mathias-aland/battery-monitor-v1/README.md

# battery-monitor-v1
PCBs created with EAGLE 7.7.0  
Gateway FW created with ESP-IDF Eclipse  
Node FW created with Simplicity Studio  
**More info will be added later!**
