mathias-aland/battery-monitor-v1/hw/batt_mon_v1_gateway/wifi_lora_gw_v1_1.pdf

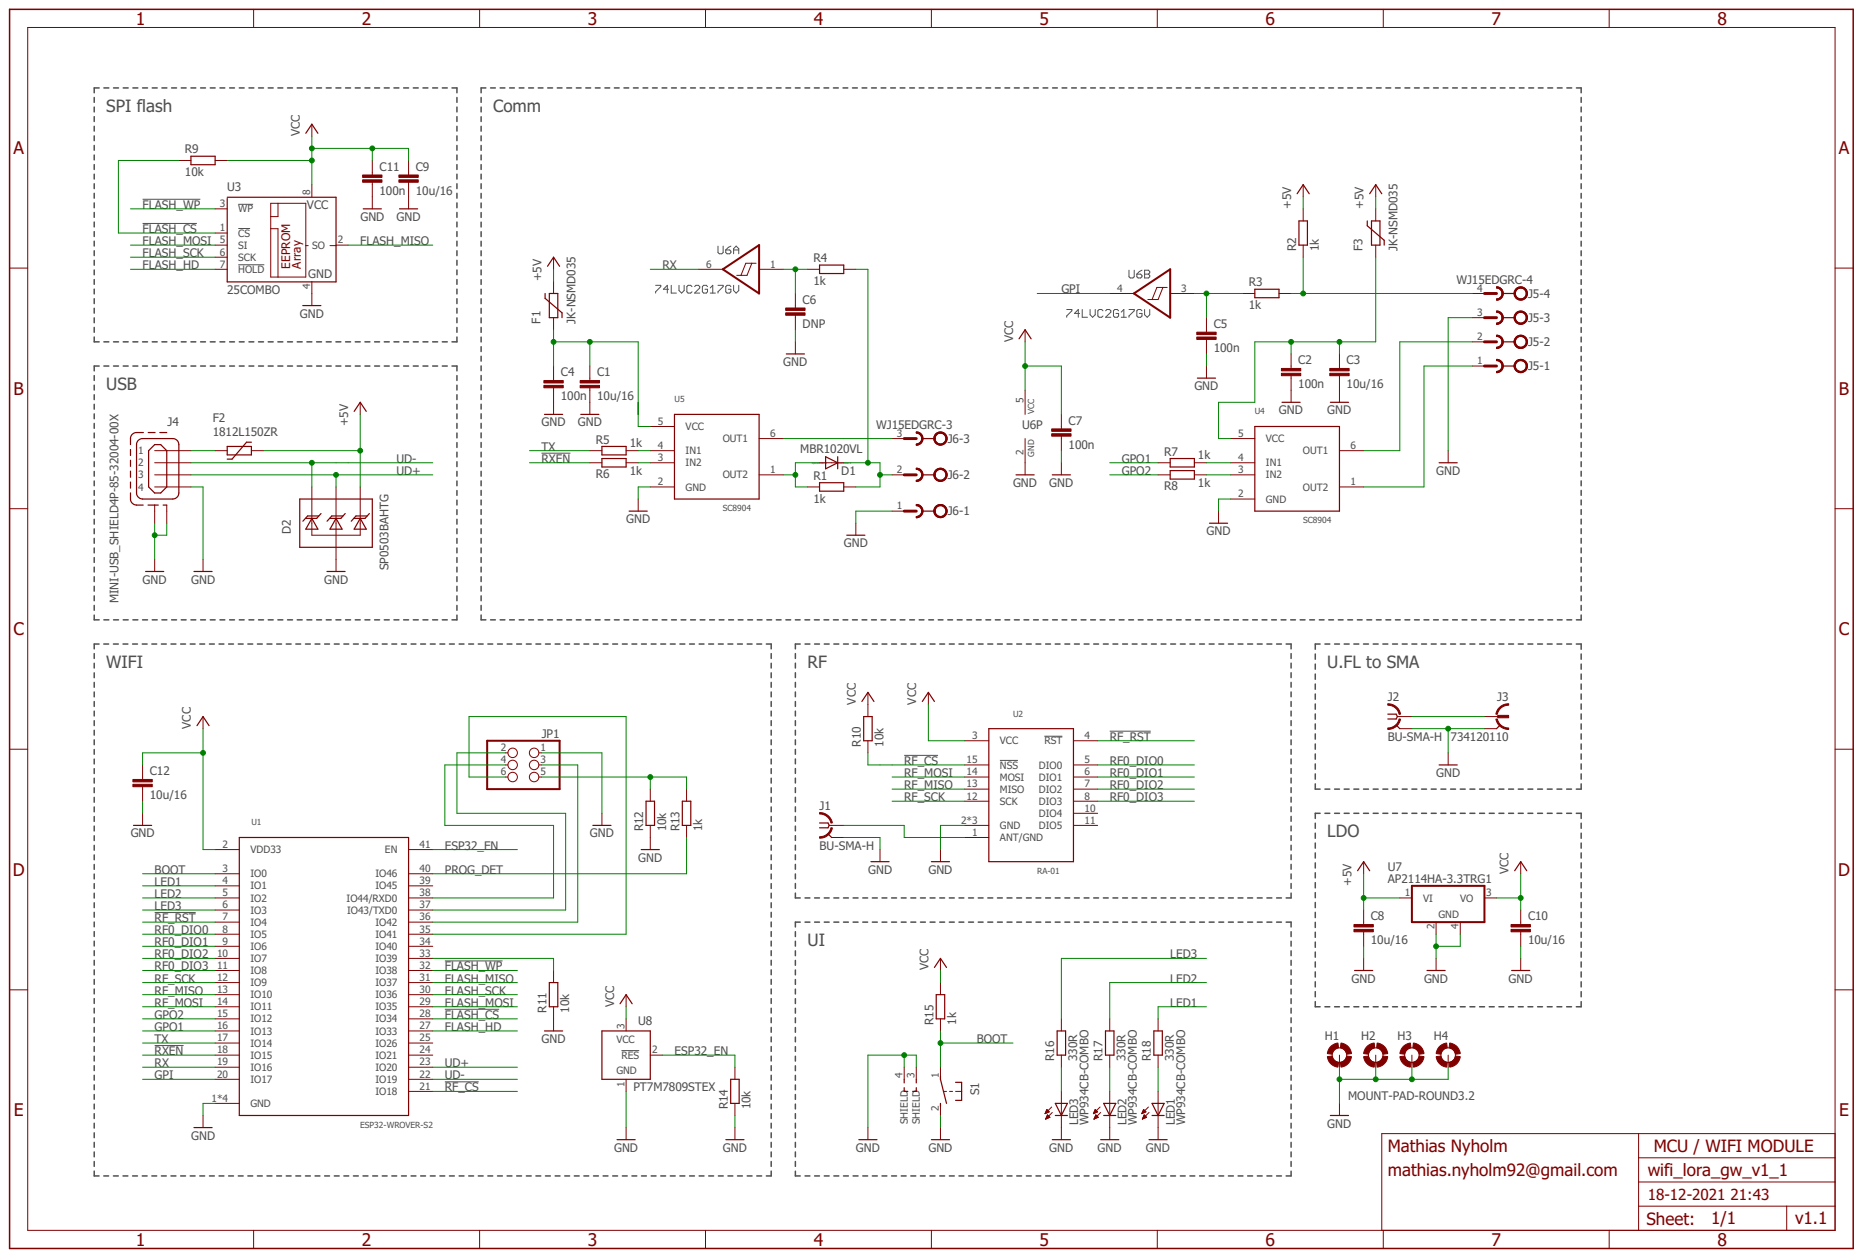
[picture p1: page 1]
