mathias-aland/battery-monitor-v1/hw/batt_mon_v1/batt_mon_v1.pdf

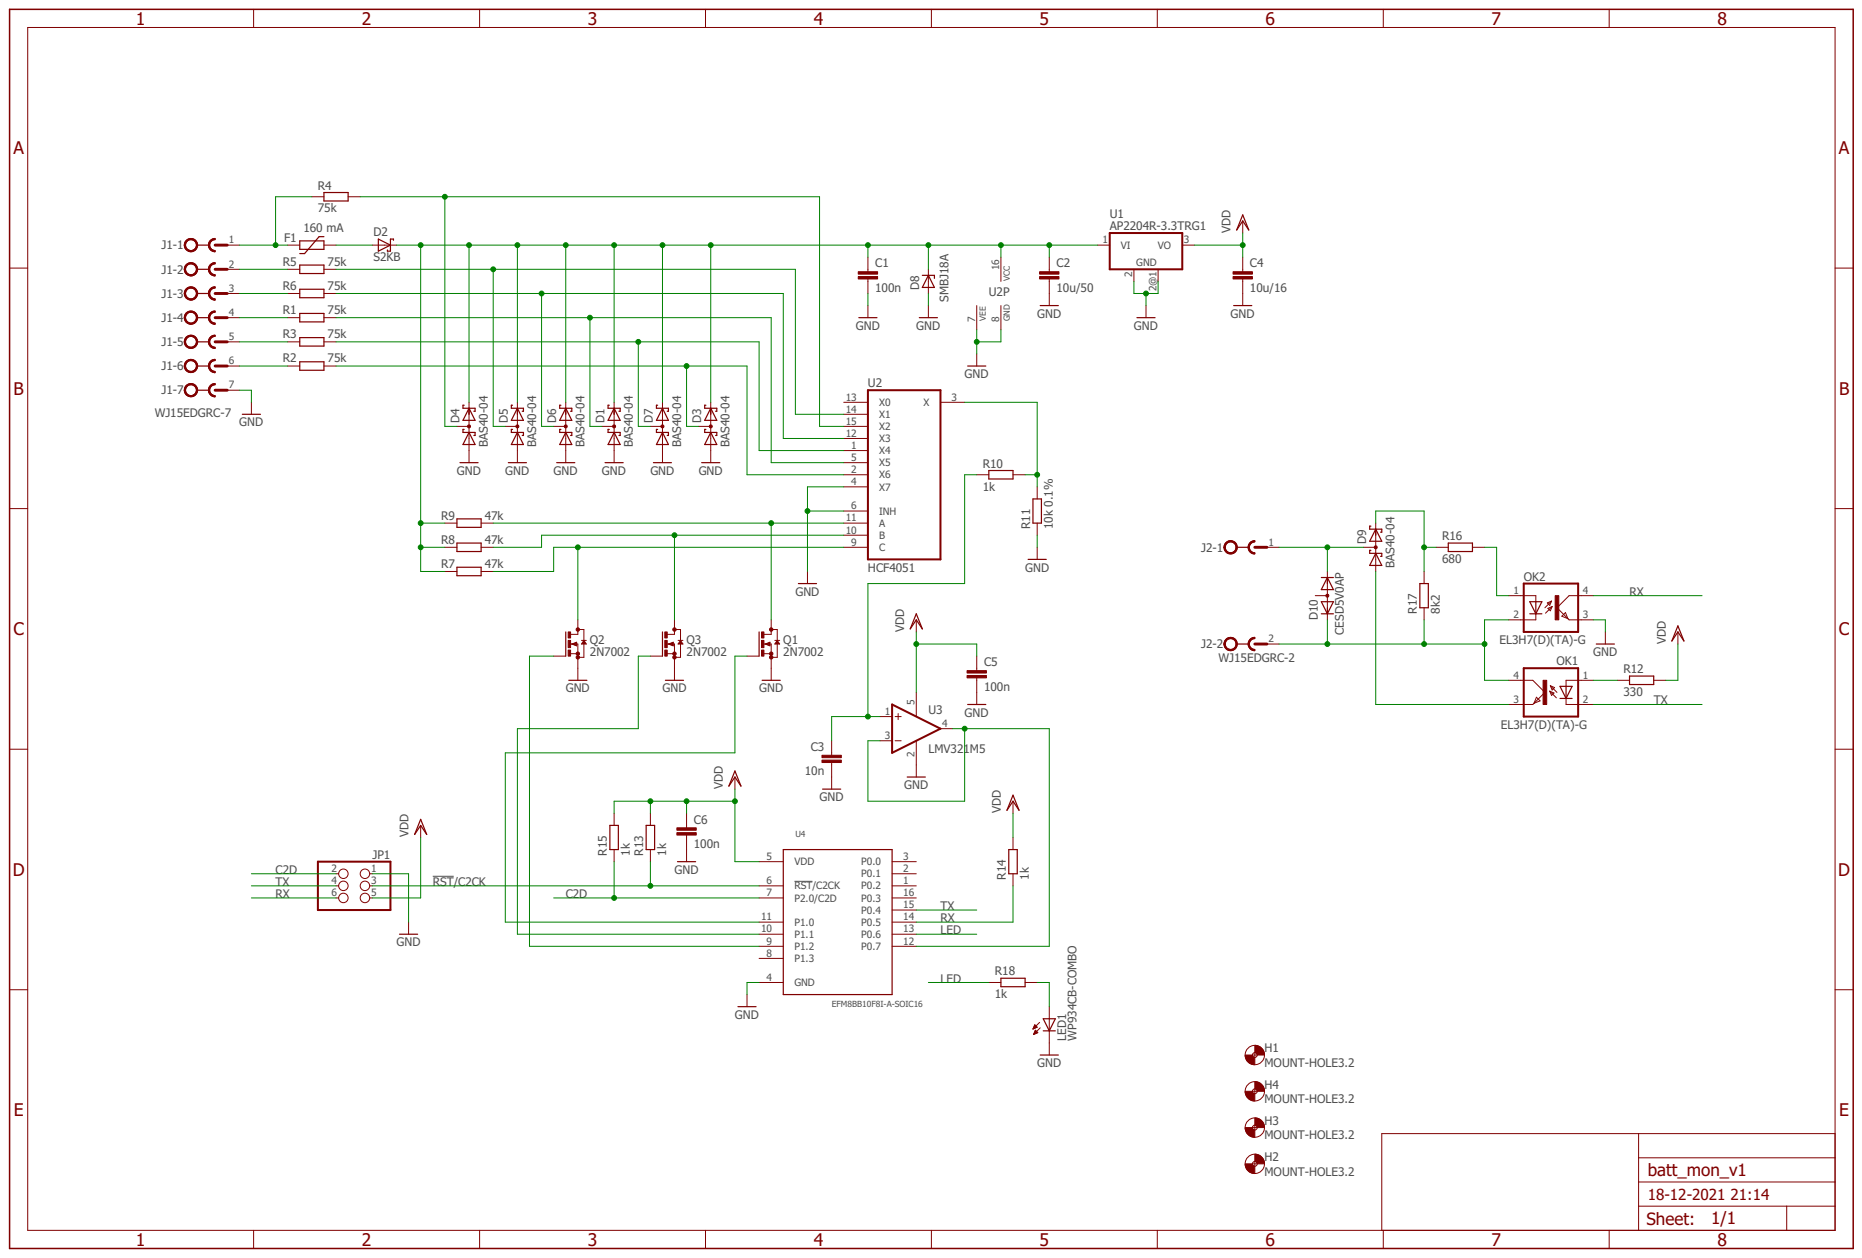
[picture p2: page 1]
