mathias-aland/battery-monitor-v1/hw/batt_mon_v1_gateway/wifi_lora_gw_v1_1.brd

## EAGLE design hw/batt_mon_v1_gateway/wifi_lora_gw_v1_1.brd (2021-12-18)

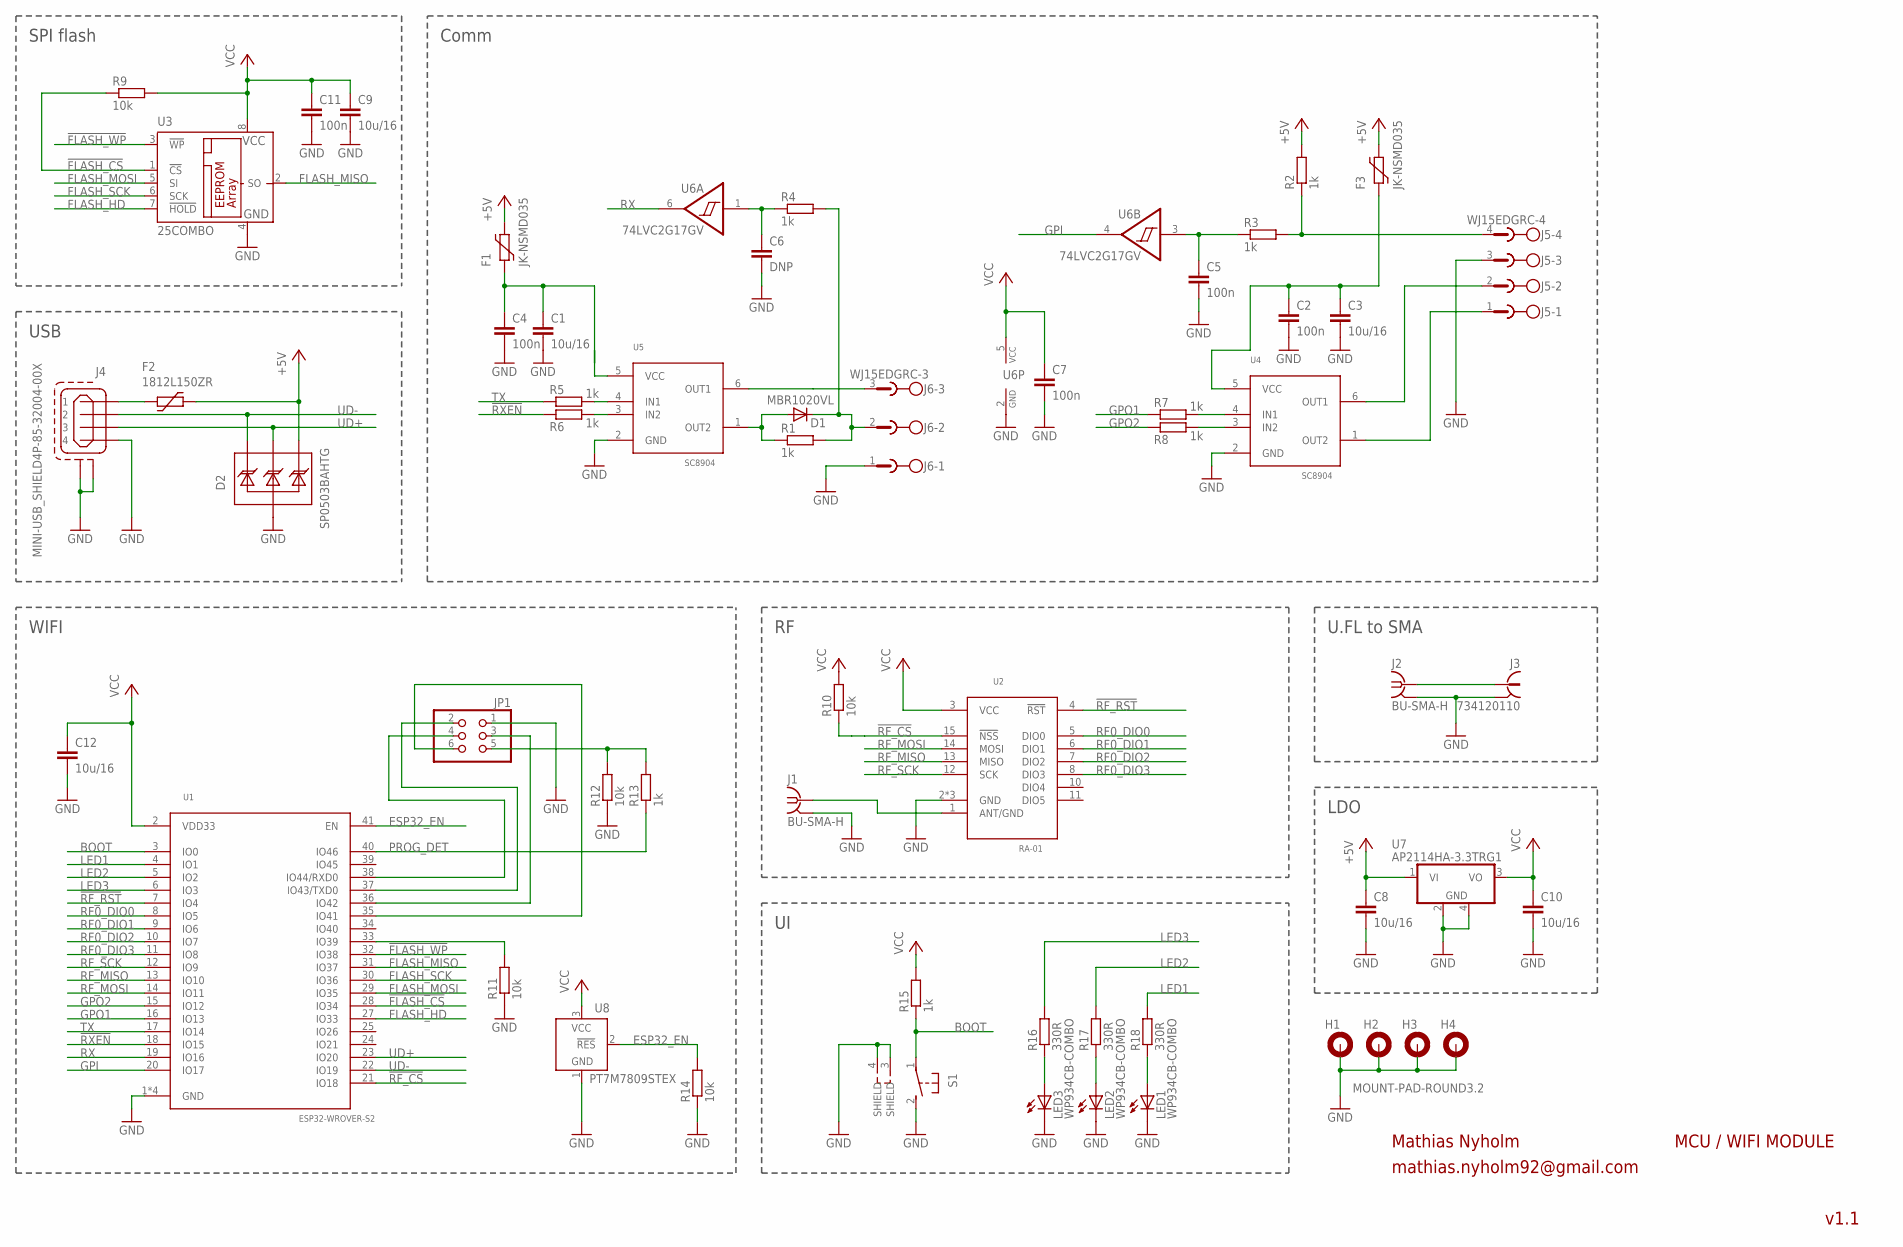
[picture p3: schematic wifi_lora_gw_v1_1.sch]

Parts:
C1, C3, C8, C9, C10, C12: 10u/16; C1206
C2, C4, C5, C7, C11: 100n; C0805
C6: DNP; C0805
D1: MBR1020VL; SOD123
D2: SP0503BAHTG; SOT143
F1, F3: JK-NSMD035; 1206L
F2: 1812L150ZR; 1812L
H1, H2, H3, H4: MOUNT-PAD-ROUND3.2; 3,2-PAD
J1, J2: BU-SMA-H
J3: 734120110
J4: MINI-USB_SHIELD4P-85-32004-00X; 85-32004-00X
J5: WJ15EDGRC-4; WJ15EDGRC-3.81-4
J6: WJ15EDGRC-3; WJ15EDGRC-3.81-3
JP1: PINHD-2X3; 2X03
LED1, LED2, LED3: WP934CB-COMBO
R1, R2, R3, R4, R5, R6, R7, R8, R13, R15: 1k; R0805
R9, R10, R11, R12, R14: 10k; R0805
R16, R17, R18: 330R; R0805
S1: 31-XX; B3F-31XX
U1: ESP32-WROVER-S2; ESP32-WROVER-I-S2
U2: RA-01; RA-02
U3: 25COMBO; SO-08M-COMBO
U4, U5: SC8904; SOT23-6L
U6: 74LVC2G17GV; SOT23-6L
U7: AP2114HA-3.3TRG1; SOT223
U8: PT7M7809STEX; SOT23B-3

Connections:
!FLASH_CS: R9.1, U1.28 (IO34), U3.1 (!CS)
!FLASH_WP: U1.32 (IO38), U3.3 (!WP)
!RF_CS: R10.1, U1.21 (IO18), U2.15 (!NSS!)
!RF_RST: U1.7 (IO4), U2.4 (!RST!)
!RXEN: R6.1, U1.18 (IO15)
+5V: C8.1, D2.4 (C3), F1.P$2 (2), F2.P$2 (2), F3.P$2 (2), R2.2, U7.1 (VI)
BOOT: R15.1, S1.1, U1.3 (IO0)
ESP32_EN: R14.2, U1.41 (EN), U8.2 (!RES)
FLASH_HD: U1.27 (IO33), U3.7 (!HOLD)
FLASH_MISO: U1.31 (IO37), U3.2 (SO)
FLASH_MOSI: U1.29 (IO35), U3.5 (SI)
FLASH_SCK: U1.30 (IO36), U3.6 (SCK)
GND: C1.2, C2.2, C3.2, C4.2, C5.2, C6.2, C7.2, C8.2, C9.2, C10.2, C11.2, C12.2, D2.1 (A), H1.B3,2, H2.B3,2, H3.B3,2, H4.B3,2, J1.2 (GND), J1.3 (GND), J1.4 (GND), J1.5 (GND), J2.2 (GND), J2.3 (GND), J2.4 (GND), J2.5 (GND), J3.S@1 (2), J3.S@2 (2), J3.S@3 (2), J4.4, J4.M1 (S1), J4.M2 (S2), J5.3, J6.1, JP1.1, LED1.K (C), LED1.K1 (C), LED2.K (C), LED2.K1 (C), LED3.K (C), LED3.K1 (C), R11.1, R12.1, R14.1, S1.2 (S), S1.3 (SHIELD), S1.4 (SHIELD), U1.1 (GND), U1.26 (GND), U1.42 (GND), U1.43 (GND), U2.2 (GND), U2.9 (GND), U2.16 (GND), U3.4 (GND), U4.2 (GND), U5.2 (GND), U6.2 (GND), U7.2 (GND), U7.4 (GND), U8.1 (GND)
GPI: U1.20 (IO17), U6.4 (O)
GPO1: R7.1, U1.16 (IO13)
GPO2: R8.1, U1.15 (IO12)
LED1: R18.2, U1.4 (IO1)
LED2: R17.2, U1.5 (IO2)
LED3: R16.2, U1.6 (IO3)
unnamed: LED1.A, LED1.A1 (A), R18.1
unnamed: JP1.5, R12.2, R13.2
unnamed: D1.A, R1.1, U5.1 (OUT2)
unnamed: R5.2, U5.4 (IN1)
unnamed: F2.P$1 (1), J4.1
unnamed: JP1.4, U1.38 (IO44/RXD0)
unnamed: JP1.3, U1.36 (IO42)
unnamed: R11.2, U1.33 (IO39)
unnamed: JP1.6, U1.35 (IO41)
unnamed: JP1.2, U1.37 (IO43/TXD0)
unnamed: C1.1, C4.1, F1.P$1 (1), U5.5 (VCC)
unnamed: D1.C, J6.2, R1.2, R4.2
unnamed: J5.4, R2.1, R3.2
unnamed: J5.2, U4.6 (OUT1)
unnamed: J5.1, U4.1 (OUT2)
unnamed: C6.1, R4.1, U6.1 (I)
unnamed: R6.2, U5.3 (IN2)
unnamed: C5.1, R3.1, U6.3 (I)
unnamed: R7.2, U4.4 (IN1)
unnamed: LED3.A, LED3.A1 (A), R16.1
unnamed: LED2.A, LED2.A1 (A), R17.1
unnamed: J1.1, U2.1 (ANT/GND)
unnamed: J2.1, J3.1
unnamed: J6.3, U5.6 (OUT1)
unnamed: C2.1, C3.1, F3.P$1 (1), U4.5 (VCC)
unnamed: R8.2, U4.3 (IN2)
PROG_DET: R13.1, U1.40 (IO46)
RF0_DIO0: U1.8 (IO5), U2.5 (DIO0)
RF0_DIO1: U1.9 (IO6), U2.6 (DIO1)
RF0_DIO2: U1.10 (IO7), U2.7 (DIO2)
RF0_DIO3: U1.11 (IO8), U2.8 (DIO3)
RF_MISO: U1.13 (IO10), U2.13 (MISO)
RF_MOSI: U1.14 (IO11), U2.14 (MOSI)
RF_SCK: U1.12 (IO9), U2.12 (SCK)
RX: U1.19 (IO16), U6.6 (O)
TX: R5.1, U1.17 (IO14)
UD+: D2.3 (C2), J4.3, U1.23 (IO20)
UD-: D2.2 (C1), J4.2, U1.22 (IO19)
VCC: C7.1, C9.1, C10.1, C11.1, C12.1, R9.2, R10.2, R15.2, U1.2 (VDD33), U2.3 (VCC), U3.8 (VCC), U6.5 (VCC), U7.3 (VO), U8.3 (VCC)

Notes on the sheet:
MCU / WIFI MODULE
v1.1
Mathias Nyholm
mathias.nyholm92@gmail.com
SPI flash
USB
Comm
WIFI
U.FL to SMA
LDO

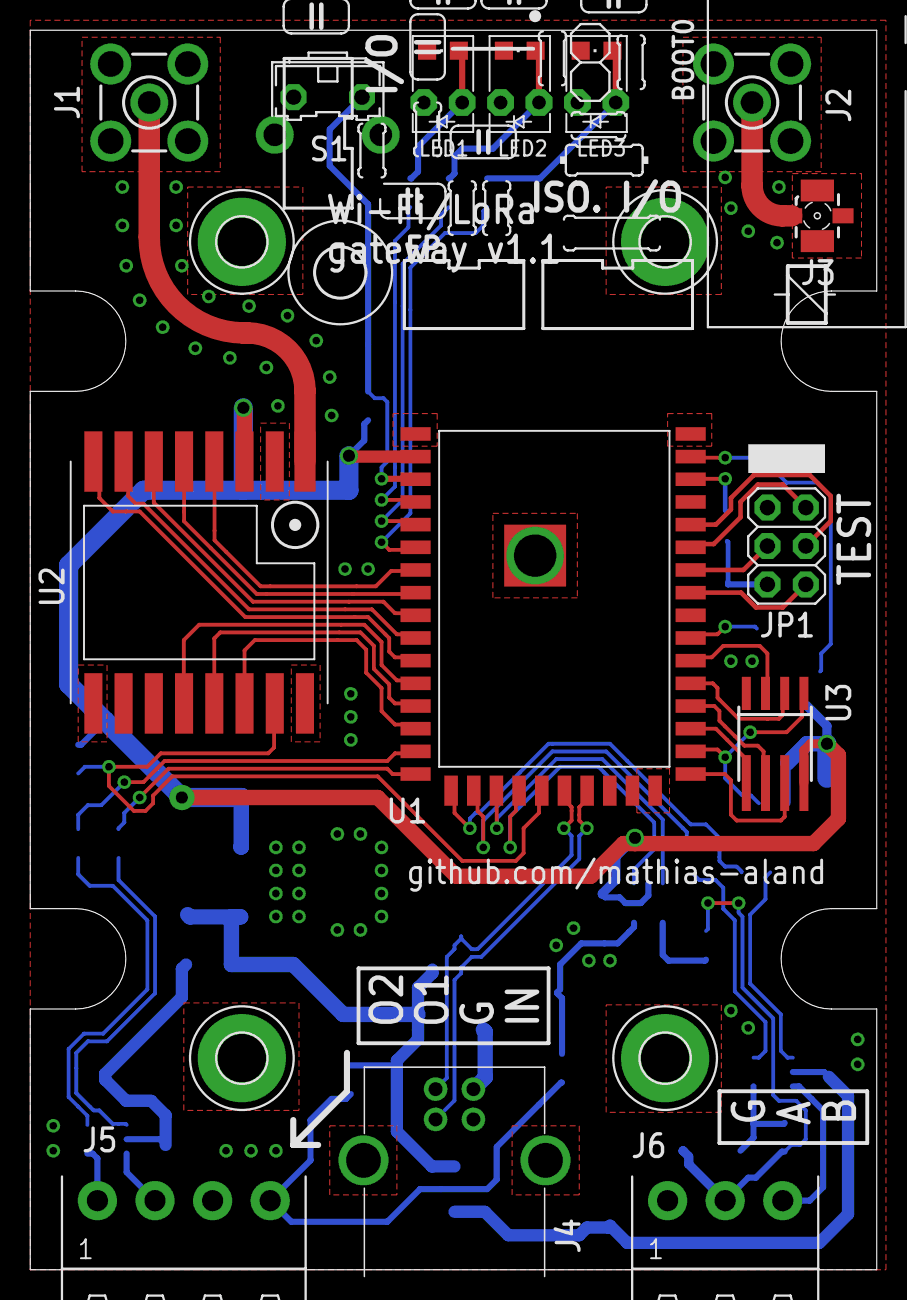
[picture p4: board wifi_lora_gw_v1_1.brd from above]

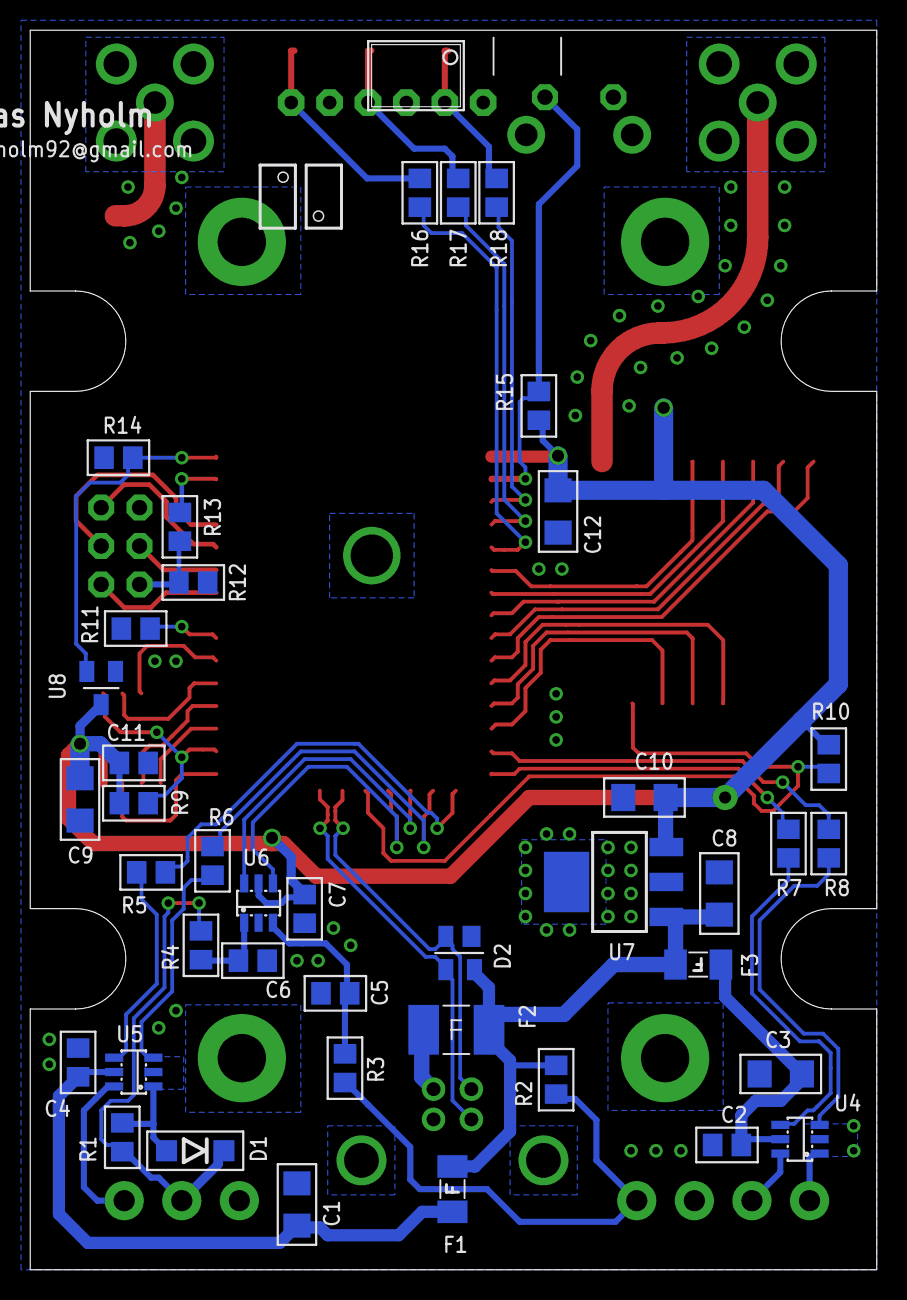
[picture p5: board wifi_lora_gw_v1_1.brd from below]

Board: 2 copper layers, 56.0 x 82.0 mm, 58 parts (40 on the bottom side), 58 nets.
