mathias-aland/battery-monitor-v1/hw/batt_mon_v1/batt_mon_v1.brd

## EAGLE design hw/batt_mon_v1/batt_mon_v1.brd (2021-12-18)

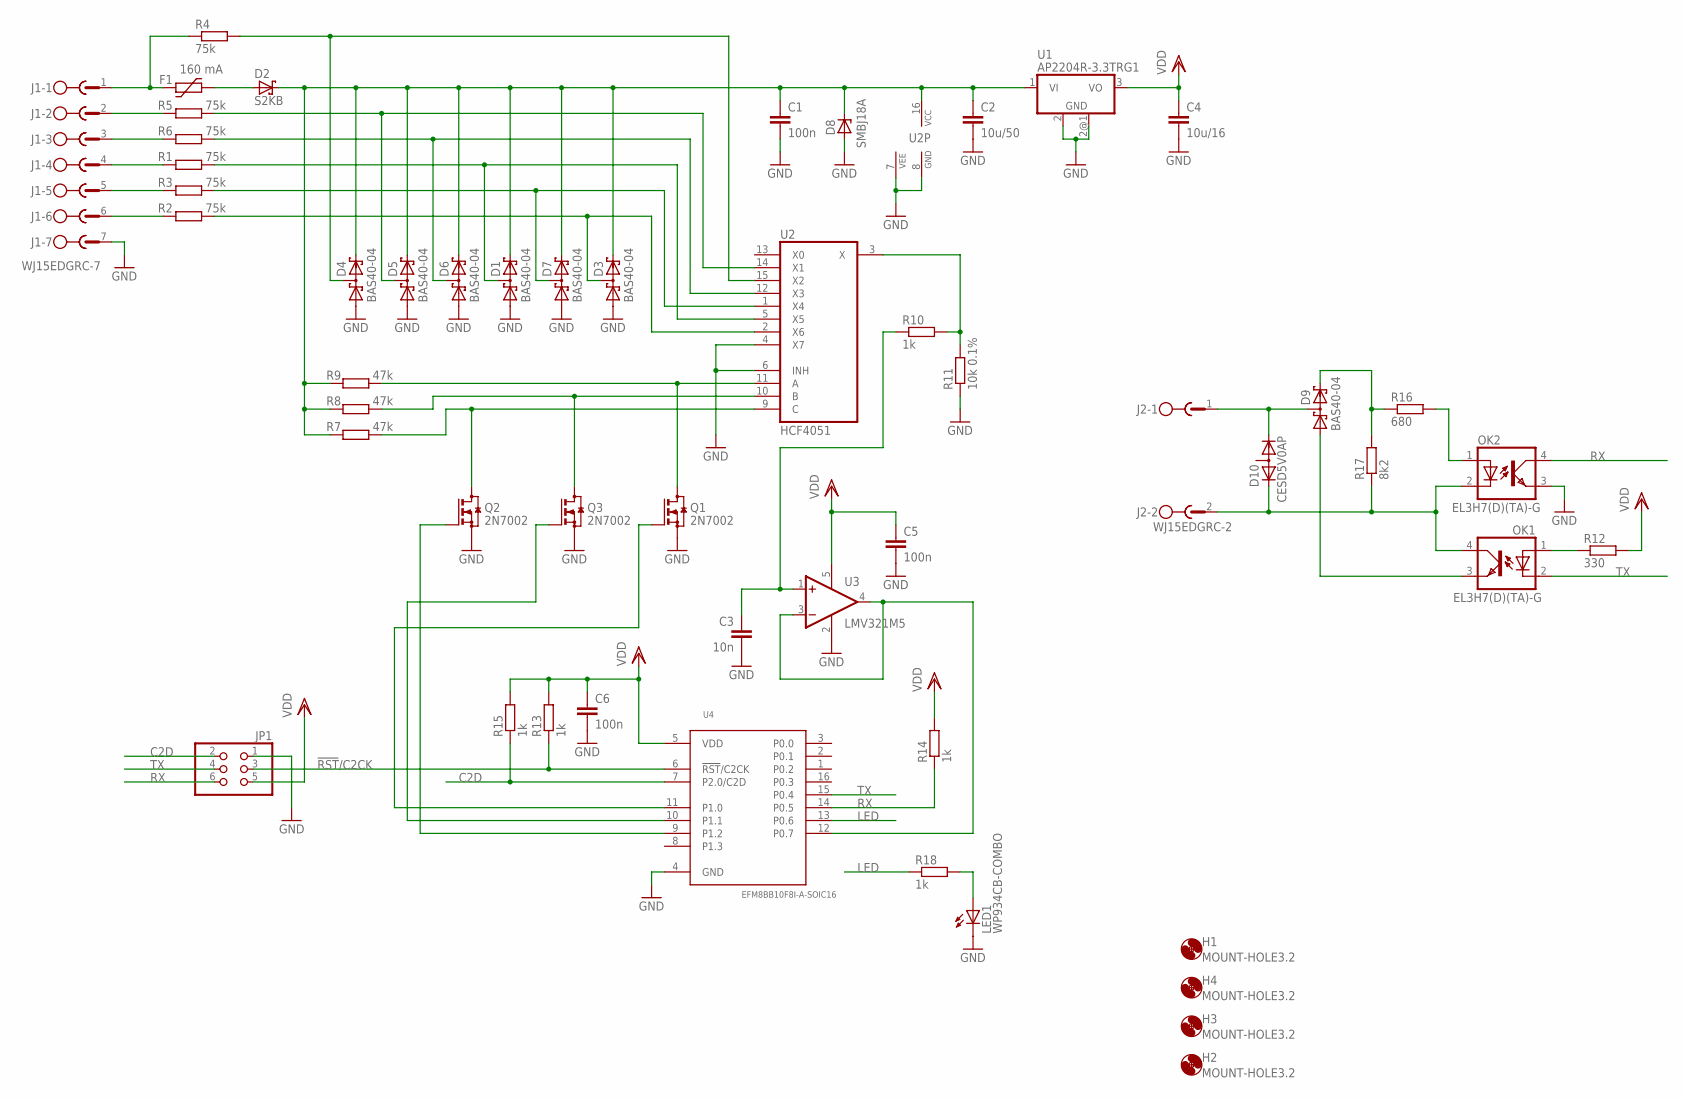
[picture p6: schematic batt_mon_v1.sch]

Parts:
C1, C5, C6: 100n; C0805
C2: 10u/50; C1206
C3: 10n; C0805
C4: 10u/16; C1206
D1, D3, D4, D5, D6, D7, D9: BAS40-04; SOT23
D2: S2KB; SMB
D8: SMBJ18A; SMB
D10: CESD5V0AP; SOT23
F1: 160 mA; 1206L
H1, H2, H3, H4: MOUNT-HOLE3.2; 3,2
J1: WJ15EDGRC-7; WJ15EDGRC-3.81-7
J2: WJ15EDGRC-2; WJ15EDGRC-3.81-2
JP1: PINHD-2X3; 2X03
LED1: WP934CB-COMBO
OK1, OK2: EL3H7(D)(TA)-G; MINI-FLAT-4
Q1, Q2, Q3: 2N7002; SOT23
R1, R2, R3, R4, R5, R6: 75k; R1206
R7, R8, R9: 47k; R0805
R10, R13, R14, R15, R18: 1k; R0805
R11: 10k 0.1%; R0805
R12: 330; R0805
R16: 680; R0805
R17: 8k2; R0805
U1: AP2204R-3.3TRG1; SOT89; MOUSER 579-MCP1755ST1802EDB
U2: HCF4051; SO16
U3: LMV321M5; SOT23-5
U4: EFM8BB10F8I-A-SOIC16; SO16

Connections:
!RST!/C2CK: JP1.3, R13.1, U4.6 (!RST!/C2CK)
C2D: JP1.2, R15.1, U4.7 (P2.0/C2D)
GND: C1.2, C2.2, C3.2, C4.2, C5.2, C6.2, D1.1 (A1), D3.1 (A1), D4.1 (A1), D5.1 (A1), D6.1 (A1), D7.1 (A1), D8.A, J1.7, JP1.1, LED1.K (C), LED1.K1 (C), OK2.3 (EMIT), Q1.2 (S), Q2.2 (S), Q3.2 (S), R11.1, U1.2 (GND), U1.2@1 (GND), U2.4 (X7), U2.6 (INH), U2.7 (VEE), U2.8 (GND), U3.2 (V-), U4.4 (GND)
LED: R18.1, U4.13 (P0.6)
unnamed: R10.2, R11.2, U2.3 (X)
unnamed: Q1.3 (D), R9.2, U2.11 (A)
unnamed: Q3.3 (D), R8.2, U2.10 (B)
unnamed: Q2.3 (D), R7.2, U2.9 (C)
unnamed: D1.3 (C1A2), R1.2, U2.5 (X5)
unnamed: F1.P$1 (1), J1.1, R4.1
unnamed: D4.3 (C1A2), R4.2, U2.15 (X2)
unnamed: J1.2, R5.1
unnamed: D5.3 (C1A2), R5.2, U2.14 (X1)
unnamed: D6.3 (C1A2), R6.2, U2.12 (X3)
unnamed: J1.3, R6.1
unnamed: C3.1, R10.1, U3.1 (+IN)
unnamed: D2.A, F1.P$2 (2)
unnamed: J1.4, R1.1
unnamed: Q2.1 (G), U4.9 (P1.2)
unnamed: Q3.1 (G), U4.10 (P1.1)
unnamed: Q1.1 (G), U4.11 (P1.0)
unnamed: C1.1, C2.1, D1.2 (C2), D2.C, D3.2 (C2), D4.2 (C2), D5.2 (C2), D6.2 (C2), D7.2 (C2), D8.C, R7.1, R8.1, R9.1, U1.1 (VI), U2.16 (VCC)
unnamed: J1.6, R2.1
unnamed: J1.5, R3.1
unnamed: OK2.1 (A), R16.2
unnamed: D9.1 (A1), OK1.3 (EMIT)
unnamed: OK1.1 (A), R12.1
unnamed: D9.3 (C1A2), D10.1 (K1), J2.1
unnamed: U3.3 (-IN), U3.4 (OUT), U4.12 (P0.7)
unnamed: D3.3 (C1A2), R2.2, U2.2 (X6)
unnamed: D9.2 (C2), R16.1, R17.2
unnamed: LED1.A, LED1.A1 (A), R18.2
unnamed: D7.3 (C1A2), R3.2, U2.1 (X4)
R-: D10.2 (K2), J2.2, OK1.4 (COL), OK2.2 (C), R17.1
RX: JP1.6, OK2.4 (COL), R14.1, U4.14 (P0.5)
TX: JP1.4, OK1.2 (C), U4.15 (P0.4)
VDD: C4.1, C5.1, C6.1, JP1.5, R12.2, R13.2, R14.2, R15.2, U1.3 (VO), U3.5 (V+), U4.5 (VDD)

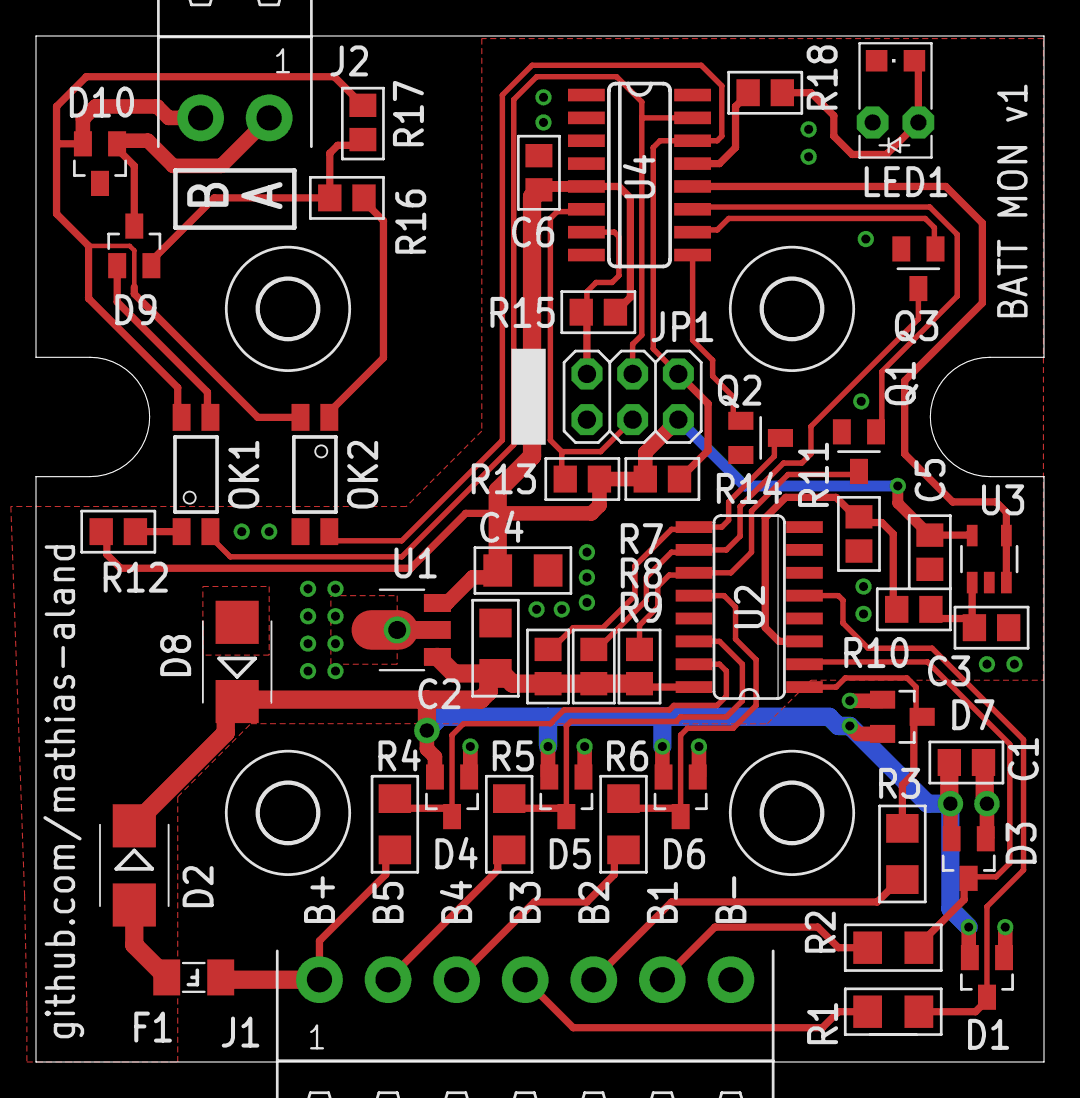
[picture p7: board batt_mon_v1.brd from above]

Board: 2 copper layers, 56.0 x 57.0 mm, 52 parts (0 on the bottom side), 37 nets.
