mathias-aland/battery-monitor-v1/(commit log)

2021-09-06 Basic functionality working
    Fetching ADC values via UART working, so far only tested with USB TTL adapter and PC software. Sleep mode implemented to save power.
2021-09-08 Add calibration and addressing functionality
    Also change to 2400 baud and some minor fixes
    [main.c]
2021-09-16 Fix tabs in boot_startup.asm
    [boot_startup.asm]
2021-12-16 Use 0x00 as failsafe address in bootloader
    [boot.h, boot_startup.asm]
2021-12-16 Fix bugs and add functionality in main FW
    [cobs.c, common.h, main.c, utils.asm]
2021-12-16 Add Wi-Fi GW code
    [partitions.csv]
2021-12-18 Add schematic and layout for nodes
    [batt_mon_v1.brd, batt_mon_v1.sch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]
2021-12-18 Add missing paste layers for node PCB
    [batt_mon_v1.GBP, batt_mon_v1.GTP]
2021-12-18 Add schematic and layout for gateway
    [wifi_lora_gw_v1_1.GBL, wifi_lora_gw_v1_1.GBO, wifi_lora_gw_v1_1.GBP, wifi_lora_gw_v1_1.GBS, wifi_lora_gw_v1_1.GTL, wifi_lora_gw_v1_1.GTO, wifi_lora_gw_v1_1.GTP, wifi_lora_gw_v1_1.GTS]
